jeetmagician/flood/(commit log)

2026-10-01 Aquaiots: firmware, single-page website and documents
    LoRa water-level telemetry. Sender (ESP32), receiver (ESP8266, cloud and
    offline versions), the one-file PHP backend, the single-page website with
    client and administrator sign-in, circuit and test documents.
2026-10-01 Website: two-door start screen, logo, founder photo, contact details
    Start screen with Client and Administrator sign-in, Water tank / River view
    filter for clients, full Aquaiots logo, founder photo, social icons and
    links, customer care number and address. Client and admin logout are now
    independent.
2026-10-01 Docs: update CLAUDE.md and START-HERE, add firmware as .txt
    CLAUDE.md/AGENTS.md now describe the single-page site, tank/river view
    filter, brand and contact details, local PHP testing, git rules and the
    known open items. Firmware sketches copied to 1-firmware/txt as plain text.
2026-10-01 Website: circuit-board texture background and light/dark theme switch
    Circuit photo embedded as a luminance mask so one image takes either theme's
    colour. Light theme with tokens for every surface, status tint and drawing,
    a switch in the top bar remembered in localStorage, and a fix for the chart
    area gradient colour. CLAUDE.md updated with the theme and texture rules.
2026-10-01 Detect a dead sensor: SENSOR LOST state, plus the implementation guide
    The cloud receiver now uploads "age", the seconds since it last heard the
    sensor over LoRa (-1 = never). api.php stores no reading and flags the device
    when the sensor is unheard for SENSOR_LOST_SEC (30 s), upgrades older databases
    automatically, and keeps older firmware working (no age = fresh). Client
    dashboard shows SENSOR LOST and WAITING FOR SENSOR; the admin board gets a
    sensor-lost pill, count and filter without touching readings.
    Adds IMPLEMENTATION-GUIDE.md (build, test and hand-over, step by step) and
    updates CLAUDE.md, README and START-HERE.
2026-10-05 Live data every 2 s, half-hour history for 7 days, PDF reports
    Receiver uploads every 2 s over one kept-alive TLS connection, with a 2.5 s
    timeout and a 10 s back-off after a failure so a slow server can never keep the
    radio deaf; the reply is read into a fixed buffer instead of an Arduino String.
    api.php keeps the latest reading on the device row, a 2-hour live buffer for the
    live chart, and one history row per device per half hour for KEEP_DAYS (7), with
    automatic migration of older databases, pruning, and an export endpoint. The admin
    query now reads only clients and devices: it never touches readings or history.
    Dashboard polls every 2 s, has a Live / 7 days chart switch and a Download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
    [node_receiver_8266_cloud.ino]
